PackageLAN/PackageLIB/README.md

# PackageLIB
&nbsp;&nbsp;&nbsp;&nbsp;

&nbsp;&nbsp;&nbsp;&nbsp;这是一个KiCAD 6.0集成库，包含了原理图符号、元器件封装、器件的3D模型和一套配色主题。
其中：
1. 基础的原理图符号参照了GB∕T 4728.5-2018的标准，集成电路的符号使用了[自定义的标准](https://github.com/PackageLAN/PackageLIB/blob/main/PackageSTD.md)（标准攥写中）；
2. 元器件封装参照了JEDEC定义的器件外形尺寸规范，并使用了[自定义的标准](https://github.com/PackageLAN/PackageLIB/blob/main/PackageSTD.md)进行绘制；
3. 3D模型大部分是从KiCAD官方提供的库中复制，部分是从[3D ContentCentral](https://www.3dcontentcentral.cn/)中下载并作一些调整，这个库~~只提供wrl格式的3D模型~~<br>
(考虑可再编辑，3D模型全部更改为默认使用step格式 2022-10-18)；
4. 配色主题的原理图主题引用了[Solarized Light Theme](https://github.com/pointhi/kicad-color-schemes/tree/master/solarized-light)，PCB主题引用了[Nord Theme](https://github.com/pointhi/kicad-color-schemes/tree/master/nord)，并对它们作了部分更改。
5. 它可以通过KiCAD 6.0中新增的包管理工具进行安装（开发中）。

***

### BUG报告 & 功能需求

请使用[Issue Tracker](https://github.com/PackageLAN/PackageLIB/issues)报告错误和需求功能，并遵循以下要求：

1. 准确描述您遇到的问题，提供尽可能多的报错信息和复现方法。
2. 如果您有解决方法，可以尝试解决并向我们提交Pull requests。

***

### 许可证

源代码根据[AGPL-3.0许可证](https://github.com/PackageLAN/PackageLIB/tree/main/LICENSE)发布。该产品已经在Windows 10、Ubuntu 18.04和20.04下进行了测试。这是一个研究型库，希望它经常更改，并且不承认任何特定用途的适用性。

**组织：AcmeTech <br>
作者：朱彦臻, PackageLAN<br>
维护人：朱彦臻, PackageLAN, 2208213223@qq.com**
