PackageLAN/PackageLIB/(commit log)

2021-12-13 Add some general resistors package
2022-01-08 Add new schematic lib.
2022-01-11 Add KiCAD6.0 schematic libraries
2022-01-11 rearrange file to adapt kicad repo
2022-01-12 Update footprints
2022-01-16 Edit power components
2022-02-01 Add footprints
2022-02-20 Update SOT footprints
2022-02-20 Add SOT footprints
2022-02-23 Add some small semiconductor footprints
2022-02-24 Add Mechanical footprints.
2022-02-26 Add Quadrant Define and Update SOT footprints rotation.
    Important update!!!
2022-03-02 Update LGA-3030_6 footprint
2022-03-03 Update flat square footprints and add META library
2022-03-03 Update footprints for IMU
2022-03-09 Add QFN-3030_16 footprints
2022-03-11 Update SMALL-SEMI and MIDDLE-SEMI footprints
2022-03-14 Update SMALL-SEMI footprints
2022-03-18 Update SEMI footprints
2022-03-20 Update some symbols and footprints
2022-03-20 Update storage symbols and footprints
2022-03-22 Add and modified
    Add operational amplifier and edit some power components.
2022-03-27 Add and rename
    Add some OPA and rename footprints in POWER_TRANSISTOR_SMD
2022-03-30 Add isolator and change GND port define
2022-04-01 Add Buck-6B DC-DC convertor
2022-04-05 Modify and rename
    Modified some integrated-circuits' description and keyword.
    Rename basic semiconductor.
2022-04-10 Add power inductor and polar capacitor.
2022-04-19 Update footprints
    Add some XTAL_OSC and modify SMALL-SEMI
2022-05-02 Update
    Add Power_diode
    Add 2-PIN_PLASTIC
    Rename Power_transistors to Power_transistor
    Modify POWER_TRANSISTOR
2022-05-03 Add and modify
    Add BGA-7070_100
    Add TO-277A and TO-277B
    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
2022-05-05 Update HC32F460PEHB alternate pin define
2022-05-08 Add gold finger CONN. and Update HC32F460
2022-05-15 Update
    Update SSOP-2545_16.
    Update schematic symbols.
2022-05-15 Add and Update
    Add MIDDLE-SEMI footprints: QFN-5050_32, QFN-7070_56.
    Update MCU symbol: HC32F460PEHB.
2022-05-20 Update Integrated-circuit_micro-controller.kicad_sym
    Update MCU symbol: HC32F460KEUA.
2022-05-21 Update Integrated-circuit_micro-controller.kicad_sym
    Update MCU symbol: HC32F460KEUA (Add alternate).
2022-05-21 Update Integrated-circuit_micro-controller.kicad_sym
    Update MCU symbol: HC32F460 (Completed alternate).
2022-05-22 Add LTC3897EFE
    Add DCDC-controller symbol: LTC3897EFE.
    Add MIDDLE-SEMI footprint: SSOP-4497_38EP.
2022-05-22 Update SOT-23.kicad_mod
    Update shape drawing rule.
2022-05-23 Add LTC3784MPUFD
    Add DCDC-controller symbol: LTC3784MPUFD.
    Add MIDDLE-SEMI footprint: QFN-4050_28.
2022-06-03 Update SMALL-SEMI and POWER-TRANSISTOR
    Update shape drawing rule and 3D models.
2022-06-03 Update SMALL-SEMI and MIDDLE-SEMI
    Update footprints according to the new rules.
2022-06-04 Update MIDDLE-SEMI and POLAR-CAP
    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
2022-06-12 Update
    Update MCU symbol: STM32H750VBT6.
    Update MIDDLE-SEMI footprint: SSOP-4497_38EP.
    Update 2-PIN_PLASTIC.
2022-06-12 Add and Update
    Add motor controller: LV8824.
    Add sensor: LDC0851.
    Update DC-DC controller: LTC3897EFE.
2022-06-14 Update and Add
    Update MIDDLE-SEMI: Corrected footprint drawing.
    Add micro-controller: ESP32-S3 (memo).
2022-06-21 Update
    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
2022-06-21 Add CONNECTOR and rename LARGE-SEMI
2022-06-24 Update ESR footprints.
2022-06-25 Add micro-controller symbol: STM32F072C8Tx
2022-06-26 Update ESR footprints.
    Add ESR_CONTACTOR and ESR_INNER_HOLDER.
    Update ESR_RAIL and BC-0705_3.
2022-06-26 Update ESR footprints.
    Add ESR_OUTER_HOLDER.
    Update ESR_INNER_HOLDER.
2022-06-27 Update footprints.
    Add courtyard to QFP-1414_100.
    Move SOD-123HE and SOD-323HE to POWER_DIODE.
    Delete unused footprints LGA-3025_14.
    Update indicator layer of LGA-3025_14_IMU.
    Update footprints fields of STM32H750VBT6 and STM32F072C8Tx.
2022-06-27 Add micro-controller symbol: STM32F103C8Tx
2022-06-27 Add MIDDLE-SEMI footprint: MSOP-3030_10
2022-06-27 Add and update
    Add symbols: Intergrated-circuit_transistor_driver
    Add transistor_driver symbol: LM5060
    Update STM32F103C8Tx keyword: QFP_7070_48
2022-06-28 Add micro-controller symbol: STM32F103RCTx
2022-06-28 Add and update
    Add LARGE-SEMI: QFP-1010_48
    Update STM32F103C8Tx's footprint
2022-06-28 Move footprints
    Move ESR footprints to dedicated library of Electrical_Slip_Ring.
2022-06-29 Update Integrated-circuit_micro-controller.kicad_sym
    Move the body to the center when it is less than half of the symbol.
2022-06-30 Update Power_transistor.kicad_sym
    Update footprint of HSBB4052.
2022-07-01 Update
    Update transistor_driver: LM5060
    Update micro-controller: STM32F103RCTx
2022-07-01 Add
    Add symbols: Link_B2B_connector
    Add conn_01x01 to conn_01x04
    Add footprints:MECHANICAL_B2B_CONN
    Add GH1.25_Horiziontal_2
2022-07-02 Update connector and micro-controller.
    Rename folder GENERAL_CONNECTOR_SMD to CONNECTOR_BAT-CONT_SMD.
    Rename folder MECHANICAL_B2B_CONN to CONNECTOR_GH_SMD.
    Rename and update symbols library Link_B2B_connector to Link_W2B_connector.
    Add EP pin to HC32F460KEUA.
2022-07-05 Add CONNECTOR_GH_SMD footprint:GH1.25_H_3 to GH1.25_H_6 and GH1.25_V_2
2022-07-05 Update interface: TJA1051T/3's footprint
2022-07-05 Add Basic_semicondutor: Diode_LED
2022-07-06 Add 3dmodels: LED_SMD
2022-07-06 Add 2-PIN_PLASTIC_SMD: LED0402 LED0603 LED0805
2022-07-06 Add CONNECTOR_GH_SMD footprints: GH1.25_V_3 GH1.25_V_4
2022-07-06 Add
    Add footprints: CONNECTOR_AMASS_THT
    Add Connector_AMASS_THT: XT30PW_F XT30PW_M
2022-07-06 Update Link_W2B_connector.kicad_sym
    Remove _MP
2022-07-12 Fix the bug: micro-controller: STM32H750VBT6's pins don't fit the grid
2022-07-12 Add DGD05473 and update LED footprints.
2022-07-13 Updata GH_SMD: GH1.25 footprints
2022-07-13 Updated footprints according to drawing rules
    Update CONNECTOR_GH: all of GH1.25
    Update LARGE-SEMI: QFP-1010_64
    Update MIDDLE-SEMI: QFP-7070_48
2022-07-14 add the symbols of W25Q32JVSS add footprints of SOIC-5252_8
2022-07-14 Add symbols/integrated-circuit_logic.kicad_sym
2022-07-14 add the footprint of SMD-3525_2.kicad_mod
2022-07-14 Add the footprints of PINHEADER_02x03_1.27mm and PINHEADER_02x03_2.54mm
2022-07-15 add the footprint of FFC_14
2022-07-15 add the symbol of TL431 and the footprint of HOLE-04-03
2022-07-16 fix some wrong of the footprint: HOLE-04-03_1.kicad_mod and FFC_14.kicad_mod
2022-07-17 Add some symbols and footprints
2022-07-22 Rename GENERAL footprints
2022-07-28 Update footprints drawing and description
2022-07-29 Update footprints
    Rename folders and modify some objects' drawing.
2022-09-04 Update footprints of RCL.
2022-09-06 Update footprints of RCL.
    Complete general series.
2022-09-07 Update footprints of LED
2022-09-12 Update symbols and footprint of uP9636
2022-09-16 Nightly hotfix
    Update some symbols and footprints.
2022-10-07 Update POWER-CHOKE footprints
2022-10-11 Update some connectors
2022-10-12 Update type-C footprints
2022-10-13 Update HA-4_1025SS.kicad_mod
    Complete the courtyard
2022-10-14 Update 102_IntegratedCircuit_Logic.kicad_sym
    Add 74LVC1G80 D flip-flop
2022-10-27 Update some footprints
2022-10-28 Update footprints
    Add LED-4_1010 and update QFN-26_4040_IPS
2022-10-31 Update footprints
    Add DFN-14_2030 and update footprints' paste
2022-11-08 Add some footprints
2022-11-15 Update some footprints and add op-amp
2022-11-25 Update 002_Basic_SingleSemiconductor.kicad_sym
    Add footprint filter
2022-11-26 Add potentiometer footprints.
2022-11-26 Update footprint filter
2023-05-23 Adjust text high of footprints and add symbols
2023-06-16 Update some power components
2023-06-16 Update capacitor
2023-08-15 Footprints standardization
2023-11-24 Daily update
    Add some LED drivers and LED footprints.
