PackageLAN/PackageLIB/(notices)

Notices in the files:
README.md:
License: AGPL
